wtleger80/RotatorFiles/UPDATED_Main_Drive_Gear.STL

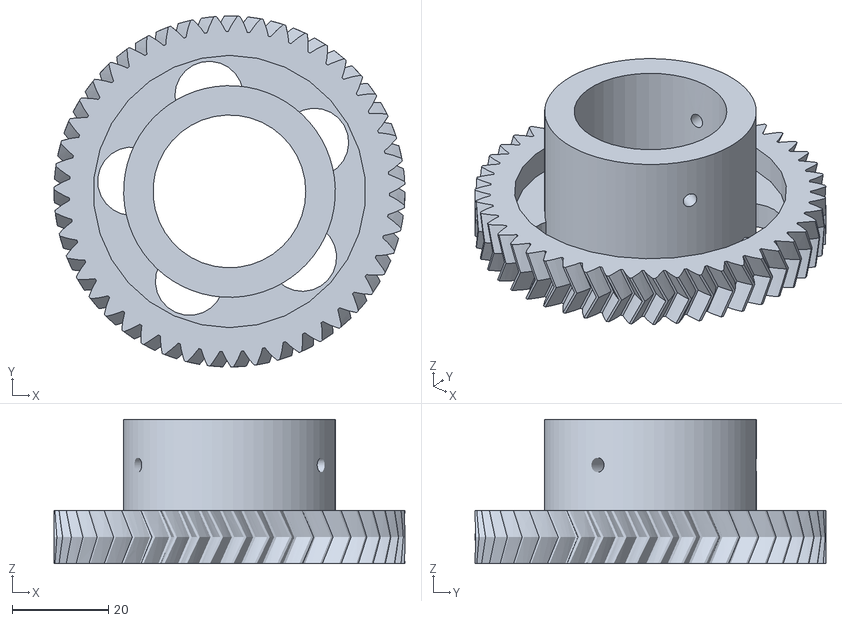
[picture p1: CAD file, 2022-07-05]
UPDATED_Main_Drive_Gear.STL
73.0 x 73.0 x 30.0
