wtleger80/RotatorFiles/Window_Blanking_Plate.stl

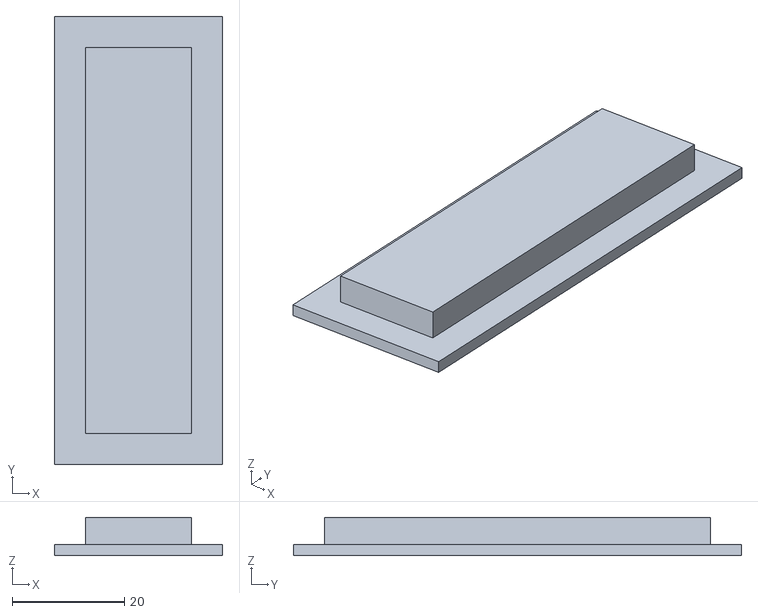
[picture p2: CAD file, 2022-07-05]
Window_Blanking_Plate.stl
30.0 x 80.0 x 6.85
