wtleger80/RotatorFiles/Pole_Mount_Clamp_Side.stl

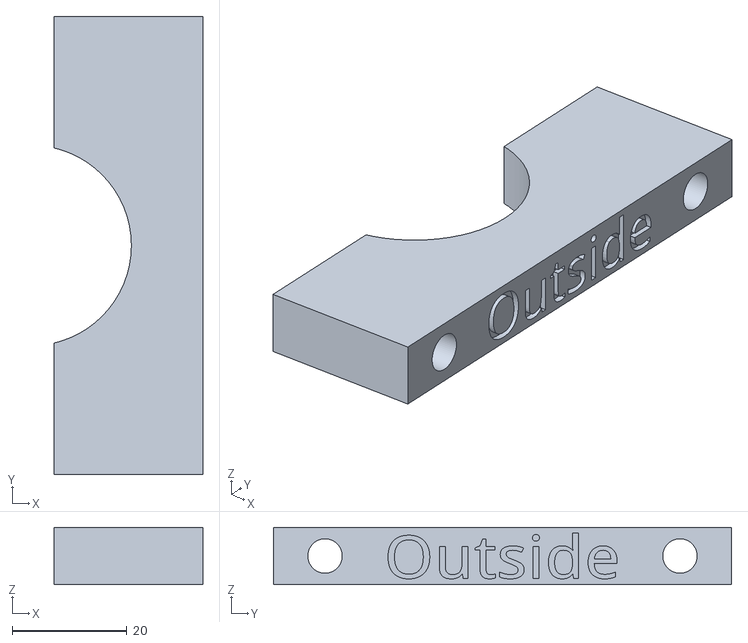
[picture p3: CAD file, 2022-07-05]
Pole_Mount_Clamp_Side.stl
26.0 x 80.0 x 10.0
