wtleger80/RotatorFiles/Pole_Mount_Case_Side.stl

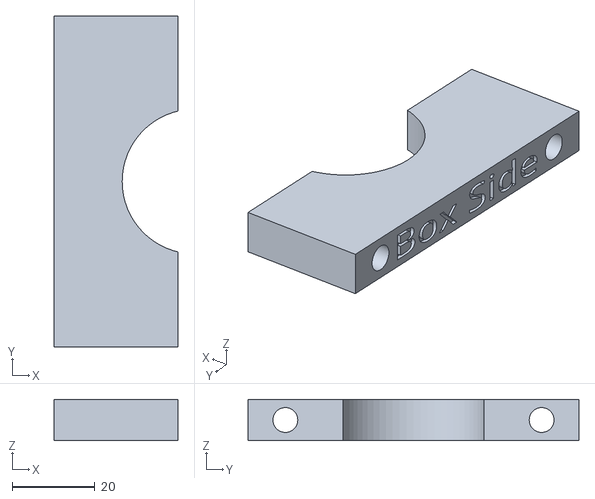
[picture p4: CAD file, 2022-07-05]
Pole_Mount_Case_Side.stl
30.0 x 80.0 x 10.0
