wtleger80/RotatorFiles/Case_Top.stl

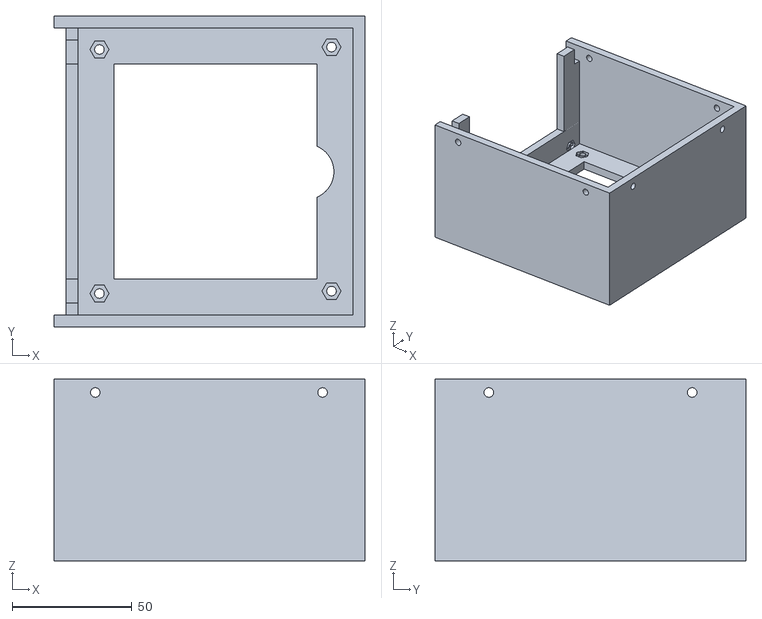
[picture p5: CAD file, 2022-07-05]
Case_Top.stl
130.0 x 130.0 x 76.0
