wtleger80/RotatorFiles/XT60_Bottom_Plate.stl

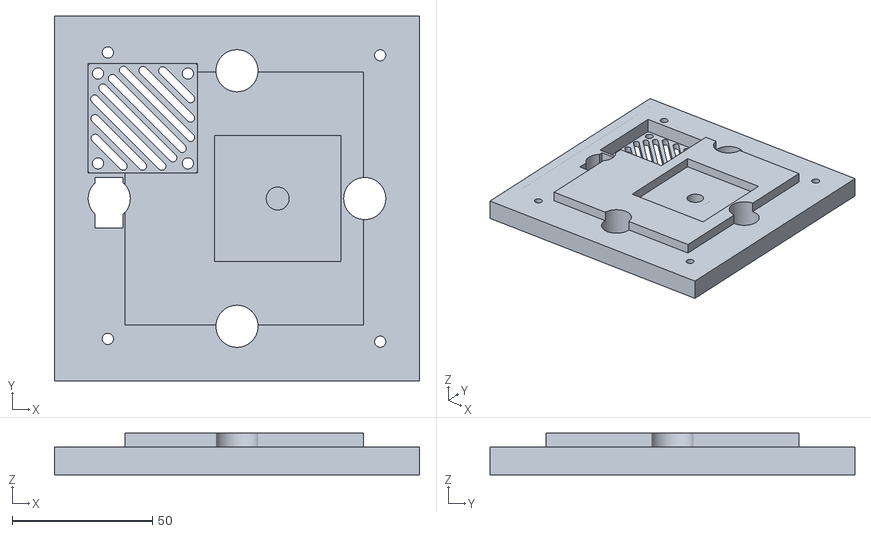
[picture p6: CAD file, 2022-07-05]
XT60_Bottom_Plate.stl
130.0 x 130.0 x 14.9
