wtleger80/RotatorFiles/UPDATED_Top_Bearing_Carrier.STL

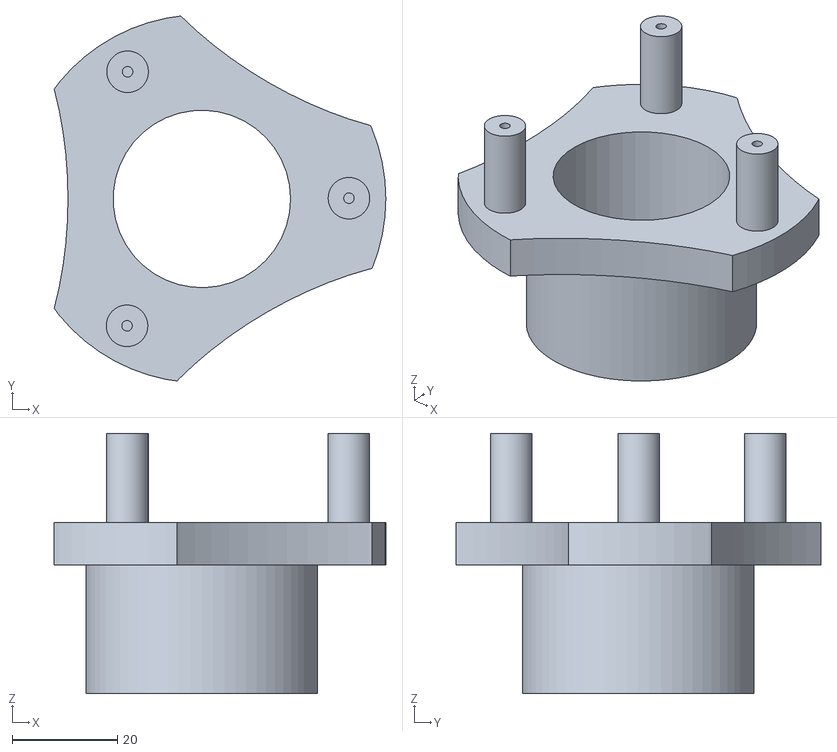
[picture p7: CAD file, 2022-07-05]
UPDATED_Top_Bearing_Carrier.STL
63.1 x 69.4 x 49.5
