wtleger80/RotatorFiles/Lower_Bearing_Holder.stl

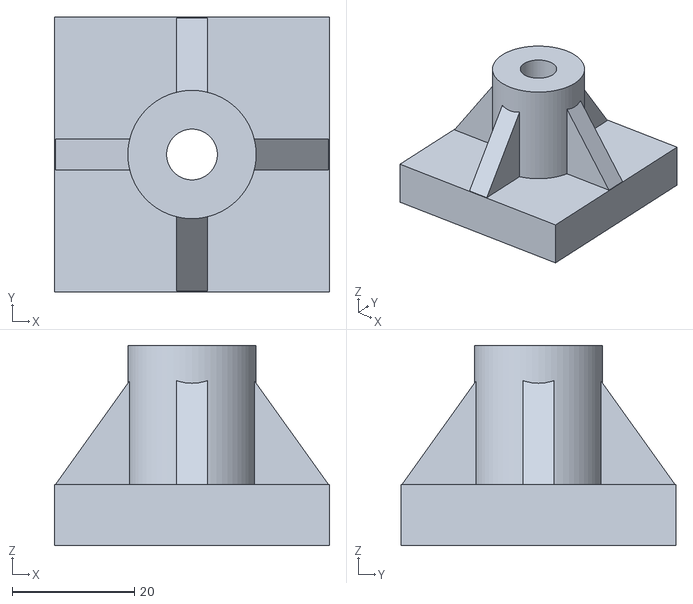
[picture p8: CAD file, 2022-07-05]
Lower_Bearing_Holder.stl
45.0 x 45.0 x 32.8
