wtleger80/RotatorFiles/UPDATED_TPU_Gasket.STL

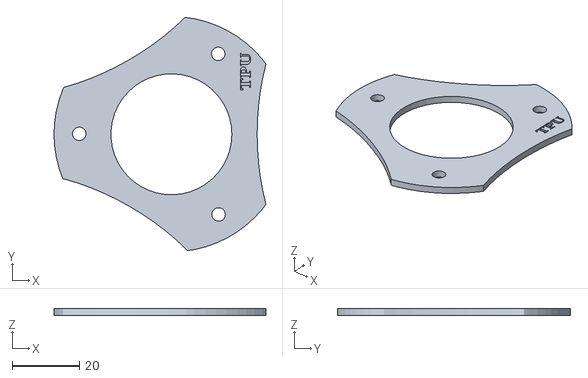
[picture p9: CAD file, 2022-07-05]
UPDATED_TPU_Gasket.STL
63.1 x 69.4 x 2.00
