wtleger80/RotatorFiles/Access_Cover_With_Window.stl

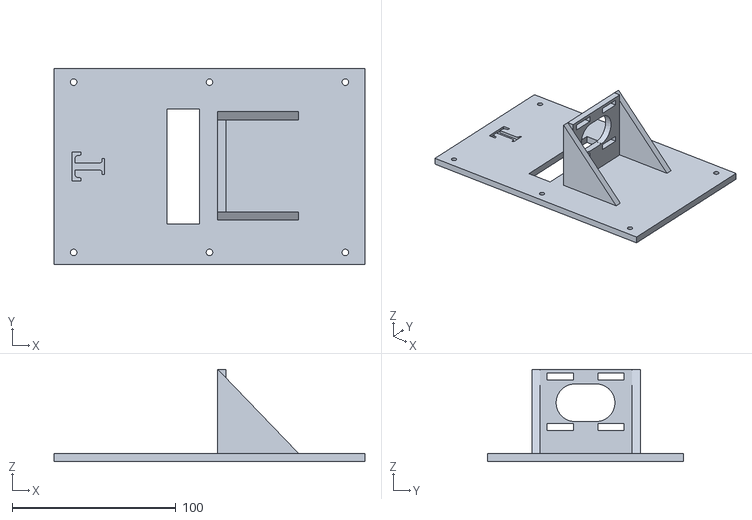
[picture p10: CAD file, 2022-07-05]
Access_Cover_With_Window.stl
190.0 x 120.0 x 56.5
