wtleger80/RotatorFiles/UPDATED_Waterproof_Top.STL

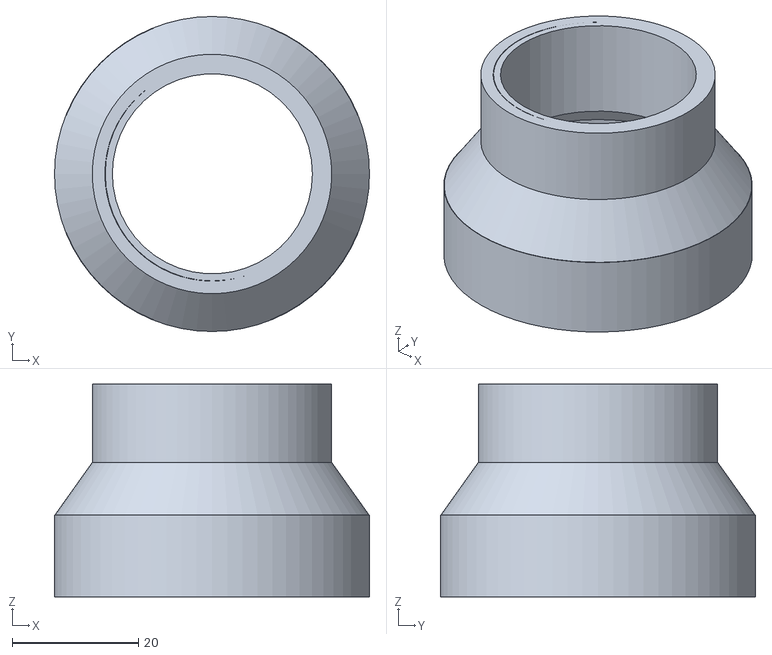
[picture p11: CAD file, 2022-07-05]
UPDATED_Waterproof_Top.STL
50.0 x 50.0 x 33.8
