wtleger80/RotatorFiles/UPDATED_Waterproof_Bottom.STL

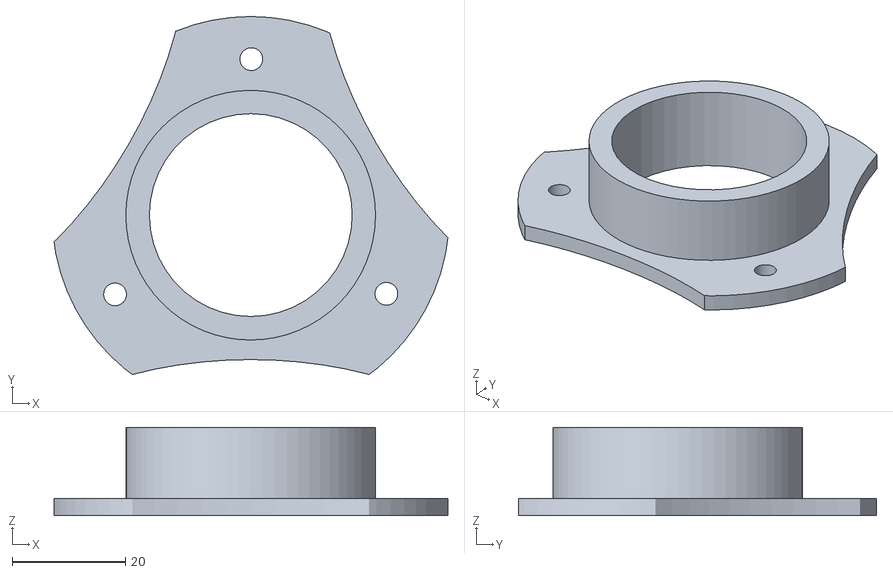
[picture p12: CAD file, 2022-07-05]
UPDATED_Waterproof_Bottom.STL
69.4 x 63.1 x 15.5
