wtleger80/RotatorFiles/UPDATED_Bottom_Tube_Mount.STL

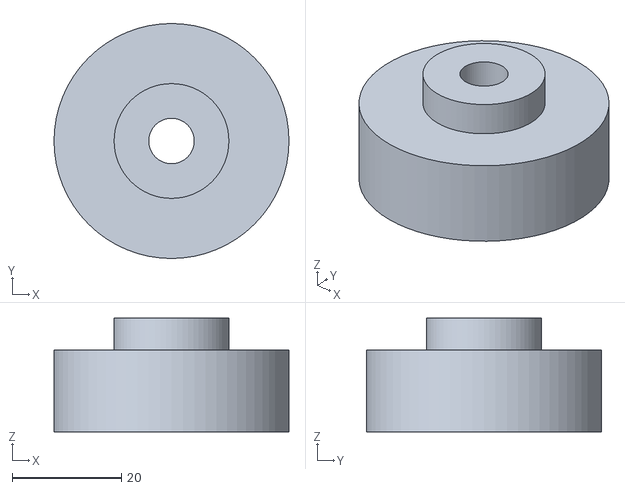
[picture p13: CAD file, 2022-07-05]
UPDATED_Bottom_Tube_Mount.STL
43.0 x 43.0 x 20.8
