wtleger80/RotatorFiles/Drive_Gear.stl

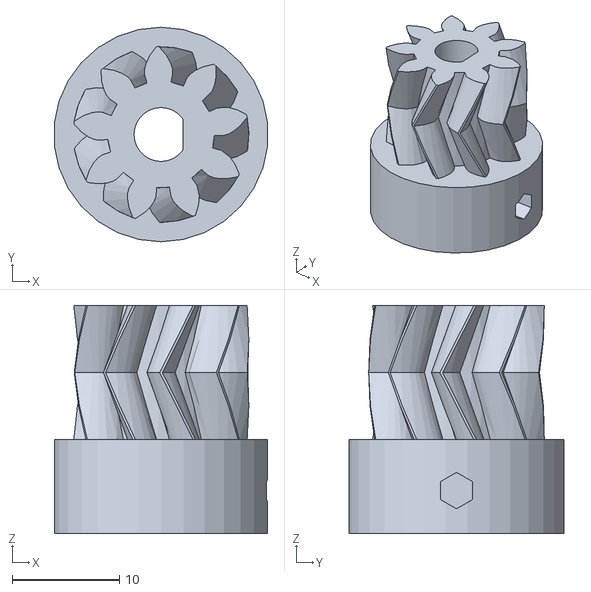
[picture p14: CAD file, 2022-07-05]
Drive_Gear.stl
19.9 x 20.0 x 21.2
