wtleger80/RotatorFiles/Case_Bottom.stl

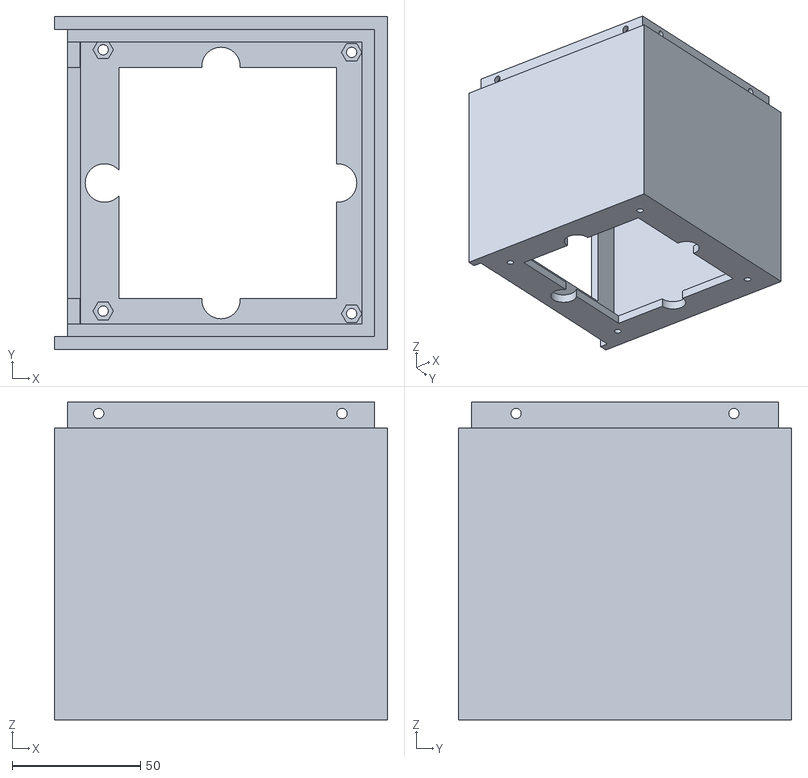
[picture p15: CAD file, 2022-07-05]
Case_Bottom.stl
130.0 x 130.0 x 124.0
