wtleger80/RotatorFiles/Access_Cover_With_Window_and_Optical_Endstop_Carrier.stl

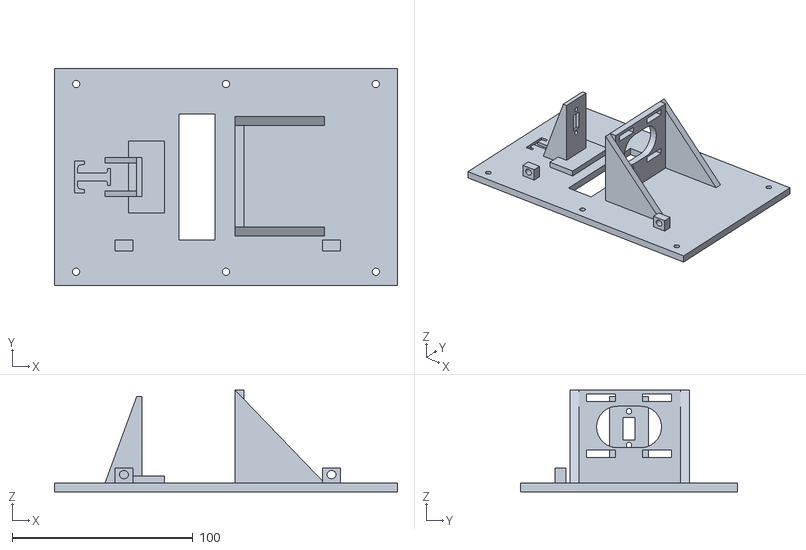
[picture p16: CAD file, 2022-07-05]
Access_Cover_With_Window_and_Optical_Endstop_Carrier.stl
190.0 x 120.0 x 56.5
