wtleger80/RotatorFiles/Optical_Endstop_Holder.stl

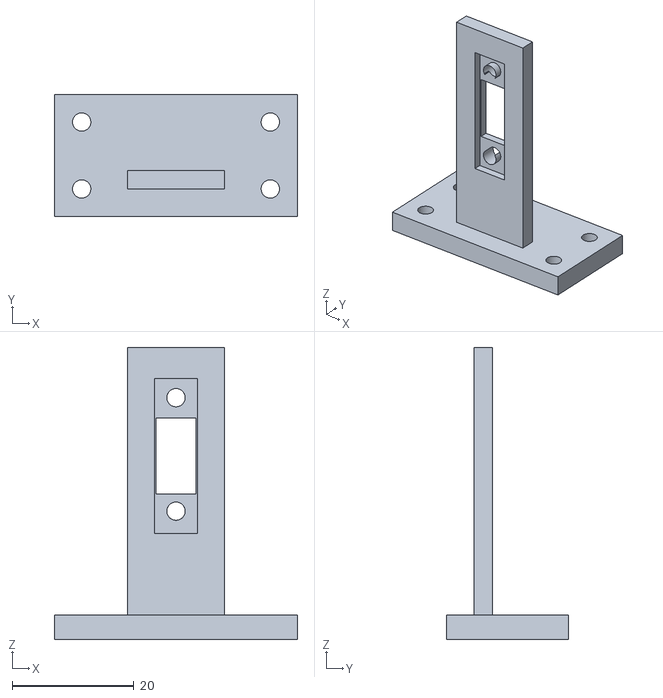
[picture p17: CAD file, 2022-07-05]
Optical_Endstop_Holder.stl
40.0 x 20.0 x 48.0
