wtleger80/RotatorFiles/UPDATED_Optical_EndStop_Interrupter.STL

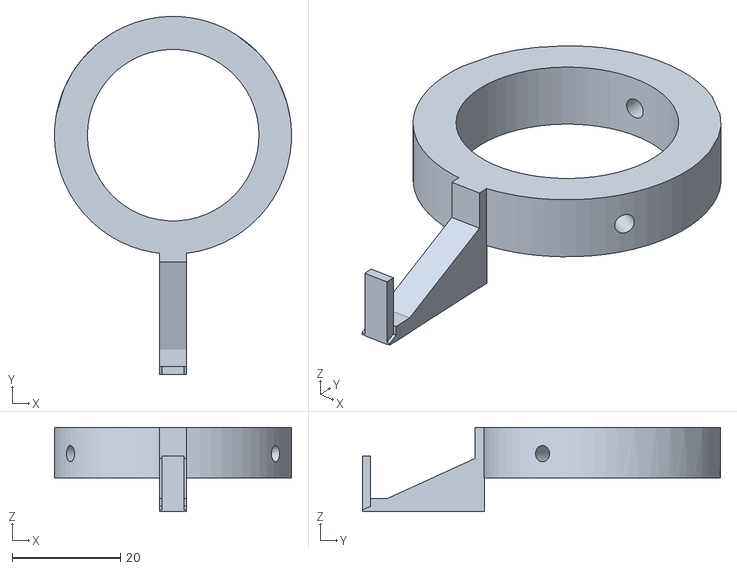
[picture p18: CAD file, 2022-07-05]
UPDATED_Optical_EndStop_Interrupter.STL
43.9 x 66.3 x 15.6
