wtleger80/RotatorFiles/UPDATED_Top_Plate.STL

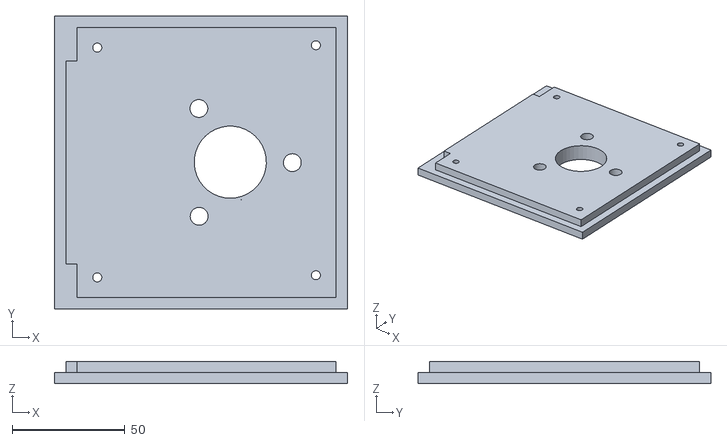
[picture p19: CAD file, 2022-07-05]
UPDATED_Top_Plate.STL
130.0 x 130.0 x 9.90
