wtleger80/RotatorFiles/ERC Version 4/PDF/eng_Instructions ERC RS232.pdf

ERC RS232 V4.0 | Instructions

### ___________________________________________________________________________

© Ing.-Büro E. Alba de Schmidt | Page 1 of 14 | web : www.schmidt-alba.de
Kreuzangerstr. 58 | 20210314 | email : erc@schmidt-alba.de
86399 Untermeitingen
This document is for the user only. Any publishing (printed or in electronic form) is not allowed.

Instructions

Congratulations on purchasing your EASY-ROTOR-CONTROL (ERC). This document will guide you through the needed steps for assembly, configuration and installation of the ERC. You will obtain the best result by following these instructions step by step.

Table of contents

### ___________________________________________________________________________

© Ing.-Büro E. Alba de Schmidt | Page 2 of 14 | web : www.schmidt-alba.de

## Safety-Instructions

- Don’t continue using the product if it is damaged.
- Keep electronic assemblies and components away from children.

### - Products that carry electric voltages must be handled in accordance with

instructions and regulations to avoid damage to equipment and personnel.

### - If the product must be repaired, use only original replacement parts. Using different parts may cause equipment damage and personal injury. Repairs should

be accomplished by a qualified individual.

### - Before applying main voltage the product must be securely build into a housing to

provide protection against accidental contact.
- The installation should be performed by a qualified individual.

### - Cables that carry dangerous voltages (e.g. main voltage) must be installed according to the valid instructions and regulations. The needed safety distances

must be maintained.
- Connection cables have to be chosen according to the needed diameter.
- Before working on the product all supply voltages must be disconnected.
- The product is designed to work in clean and dry areas inside buildings.
- Protect the product from humidity, water and heat.
- Don’t use the product in areas where explosive gas, vapour or dust may occur.

### - Don’t let the product fall or apply mechanical stress as the product may be

damaged.

### ___________________________________________________________________________

© Ing.-Büro E. Alba de Schmidt | Page 3 of 14 | web : www.schmidt-alba.de

## 1. Bill of Material (BOM)

The Bom is in the order how you should use the parts.
ERC RS232 V4.0 Bill Of Material
QTY | Type | Value | Pitch | Reference | Comments
RS232-Cable
1 | Cabel with Phonejack | 3.5mm Stereo 1.25m | for RS232 Adapter
1 | DSUB-Connector | 9 pol. Female | for RS232 Adapter
1 | DSUB-Case | for 9 pol. | for RS232 Adapter
PCB Assembly
1 | PCB ERC | 2-layer 80x61mm V4.0
2 | Capacitor ceramic | 22p 16V 5% | 2.5 | C1,C2
1 | Crystal | 9.8304 MHz HC49U | | Q1
1 | IC-Socket | 28 pol. DIL28 | | IC1* | for IC1
2 | IC-Socket | 16 pol. DIL16 | | IC2*,IC3* | for IC2,IC3
1 | Phone-Jack | 3.5mm Stereo | | X1 | RS232
8 | Capacitor ceramic | 100n 50V 20% | 2.5 | C3-C10
7 | Capacitor Tantal | 1u 35V 20% | 2.5 | C11-C17
1 | Mini-Fuse | 1.0A | 5 | F1
1 | Voltage-Regulator | 78L05 TO92 | | IC4
1 | Pinheader | 1x2 pol. | 2.5 | JP1
3 | Resistor | 20K 5% | 2.5 | R1-R3
1 | Resistor | 39K 5% | 2.5 | R4
1 | Resistor | 220K 5% | 2.5 | R5
1 | Diode | 1N4004 | 2.5 | D1 | alt.: 1N4005-4007
2 | Coil | 10u 10% SMCC | 2.5 | L1,L2
1 | Diode | P6KE33CA | 3.81 | D2
2 | Terminal-block | 2 pol. 5mm | 5 | X3,X4
4 | Terminal-block | 3 pol. 5mm | 5 | X5-X8
1 | DC-Jack | 2.1/5.5mm | | J1 | DC
1 | Capacitor Al | 100u 16V 20% | 2.5 | C18
3 | Relais | RT424012 | | K1-K3 | alt.: F1CL012R
Mechanical Assembly and ICs on socket
1 | IC | MAX232CPE | DIL16 | IC3 | with socket
1 | IC | ULN2003AN | DIL16 | IC2 | with socket
1 | IC | MEGA328P-20PU | DIL28 | IC1 | with socket
1 | DC-Connector | 2.1/5.5/14mm | | | for DC
1 | Jumper | 2 pol. | 2.5 | JP1* | on JP1 / Reset
4 | Distance-Bolt | M3x8x6mm
8 | Spring-Wascher | 3.2mm
4 | Nuts | M3
4 | Screw | M3x6mm
2 | Mounting Angle | 11x10x7mm
1 | Cable | blue 1m 0.75sqmm | | | for installation
1 | Cable | black 1m 0.75sqmm | | | for installation
3 | Cable-Ties | 150mm | | | for installation

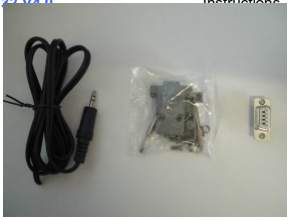
[picture p43: figure]
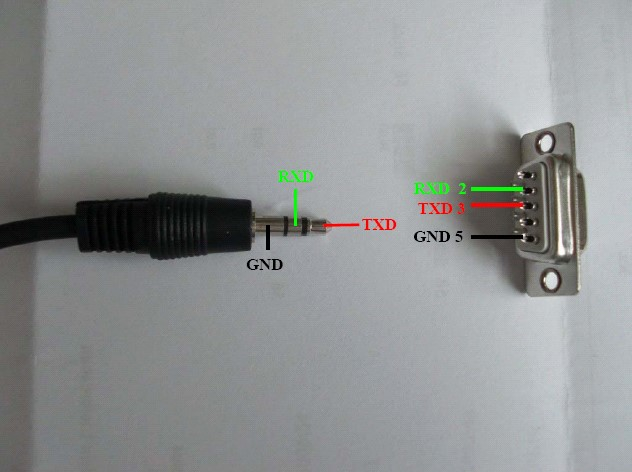
[picture p44: figure]

### ___________________________________________________________________________

© Ing.-Büro E. Alba de Schmidt | Page 4 of 14 | web : www.schmidt-alba.de

## 2. Assembly of RS232 cable

Materials needed:

- Cable with 3.5mm Stereo phone jack
- DSUB-connector 9 pole female
- DSUB-case for 9 pole

Pinning of DSUB seen from the connector-frontside

Cables shipped with the kit may differ in color. The kit builder needs to decide which of the inner cables is to be connected to what contact of the phone jack. Alternatively to the 3-wire cable a 2-wire cable with shielding may be included in the kit. For this kind of cable both shielding must be twisted together. The shielding is representing GND.

GND: inner contact (sleeve) of the phone-jack : to PIN 5 of the D-SUB
RXD: middle (ring) contact of the phone-jack : to PIN 2 of the DSUB
TXD: tip-contact of the phone-jack : to PIN 3 of the DSUB

### ___________________________________________________________________________

© Ing.-Büro E. Alba de Schmidt | Page 5 of 14 | web : www.schmidt-alba.de

## 3. Assembly of PCB

Assemble and solder the components according to the following drawings.

Please read the following instructions carefully before you start:

### 1. The vertical assembled Diodes should have a distance (1-2mm) away from the PCB while

soldering. Otherwise there is the risk of overheating these components while soldering.

### 2. Carefully observe polarization of the following components :

- Diode D1 (D2 is bidirectional, no polarization)
- Aluminum Capacitor C18
- Tantalum-Capacitors C11,C12,C13,C14,C15,C16,C17
- Voltage Regulator IC4
- IC-Sockets IC1*,IC2*,IC3*
- Connectors X3,X4,X5,X6,X7,X8 (cable entry toward the perimeter of the board)

These components are shaded in red in the following drawing.

Components :

Color code of Resistors:
20K 5% | red-black-orange-gold
alt.: 20K 1% | red-black-black-red- brown
39K 5% | orange-white-orange-gold
alt.: 39K 1% | orange-white-black-red-brown
220K 5% | red-red-yellow-gold
alt.: 220K 1% red-red-black-orange-brown

Color code of Coils:
10uH 10% brown-black-black-silver (they also resemble resistors)

Diodes :

| =

The following components are not assembled in the RS232-version: X2

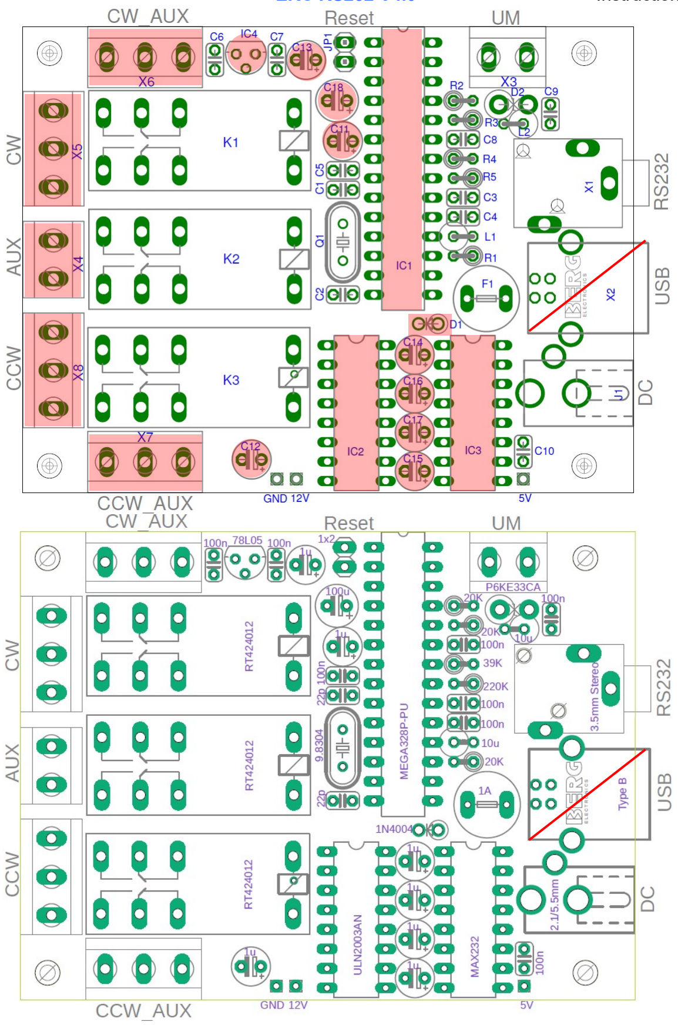
[picture p45: figure]

### ___________________________________________________________________________

© Ing.-Büro E. Alba de Schmidt | Page 6 of 14 | web : www.schmidt-alba.de


### ___________________________________________________________________________

© Ing.-Büro E. Alba de Schmidt | Page 7 of 14 | web : www.schmidt-alba.de

After assembly, attach the 4 bolts and the 2 mounting angles with nuts for mounting. Use spring-washers below the nuts.

Check the assembly carefully to insure it resembles this photo.

Do not place the ICs (MEGA328, MAX232 and ULN2003) into their sockets until the following testing is completed.

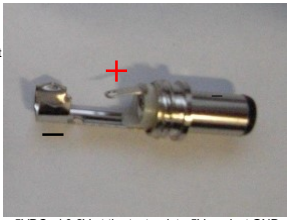
[picture p46: figure]
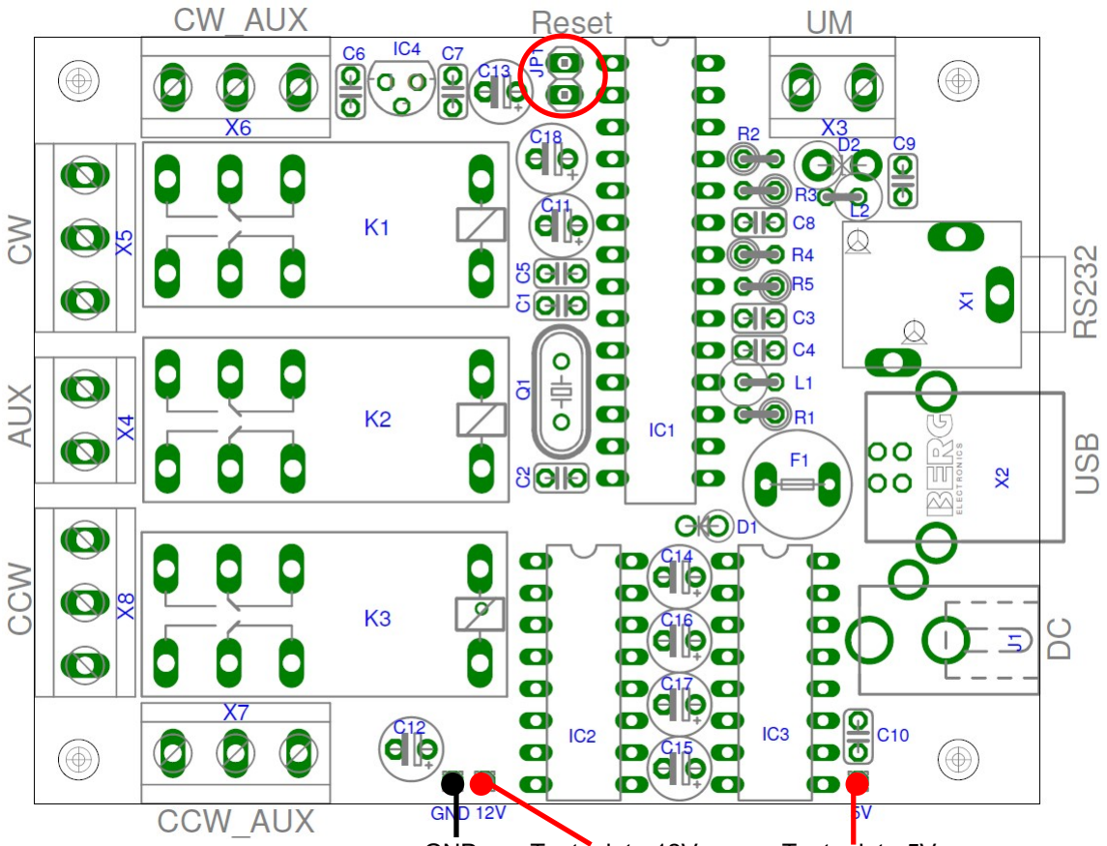
[picture p47: figure]

### ___________________________________________________________________________

© Ing.-Büro E. Alba de Schmidt | Page 8 of 14 | web : www.schmidt-alba.de

## 4. Connection of the DC-supply and check of the voltage-regulator

After checking all assembled components for identity, polarization and solder bridges, connect 11 to 15VDC to connector J1. This can be done by using the DC connector supplied with the kit or any other DC source with an appropriate DC connector of 2.1/5.5mm and Plus(+) on the centre-pin.

Connect the Plus(+)-pole to the centre contact
and the Minus(-)-pole to the outer contact.

If DC is reversed, nothing will happen as the circuit is protected from reverse polarization.

Now put the Jumper on connector JP1 (the Jumper must remain on JP1 for normal operation).

After connecting DC correctly, you should measure +5VDC +/-0.2V at the test-point +5V against GND.

GND | Testpoint +12V | Testpoint +5V

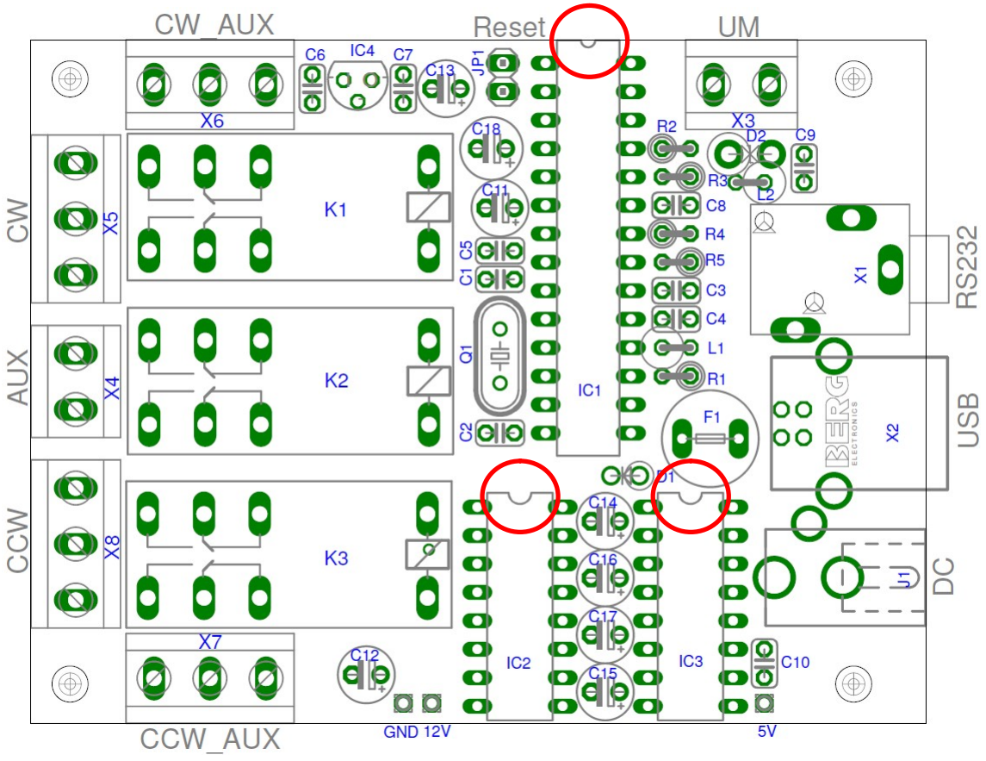
[picture p48: figure]

### ___________________________________________________________________________

© Ing.-Büro E. Alba de Schmidt | Page 9 of 14 | web : www.schmidt-alba.de

## 5. Insert ICs

Remove DC from the ERC before inserting the ICs.
The pins of the ICs have to bend before you can put them into their sockets. Use a hard base (e.g. your working desk) and
bend the row of pins slightly, that they get an angle of 90°.
Now insert the ICs and take care about direction of the components and not to bend any pins while inserting the components into the sockets.

## 6. The Service-Tool

The Service Tool is on the CD supplied with the kit.

Start the Setup-File SETUP ERC-M_Vnn.EXE (nn=version) directly on the CD and follow the instructions.

The installation wizard will automatically install the Service Tool in the program directory (or any other if you choose a different one) and put an icon on your desktop.

Connect the ERC to DC and to the PC with the RS232-cable.

Start the Service Tool by double-clicking the Icon on the desktop.

### ___________________________________________________________________________

© Ing.-Büro E. Alba de Schmidt | Page 10 of 14 | web : www.schmidt-alba.de

### 6.1 Configuration of the COM-Port

On shipment, the Service Tool is configured to COM1, which is most properly not the com-port, where you connected the ERC, hence after Start-Up the program may bring up an error-message because of the wrong COM-Port.

Choose the right COM-Port.

The Service Tool will check the availability of the ERC at the chosen COM-Port. If successful, the Service Tool will read the configuration-parameters of the ERC and populates the configuration- and the calibration-windows.

You can now perform a little hardware-test before the installation. Click the | -button and all
relays will be switched on sequentially.

### 6.2 Read the ERC-configuration-parameters

The parameters of the ERC can be read by clicking the | button.

### 6.3 Language

The Service-Tool and the help-files are available in different languages. Choose the language with the -box.

### 6.4 Configuration of the AUX-relay

Depending on the rotator used, you need to configure the function of the 3rd relay. Otherwise the rotator may not move.
Please check in the installation-guide which setting is needed for your type of rotator.
Choose the desired function in | .

### 6.5 Other functions of the Service Tool

The other functions of the Service Tool are well described in the help-function of the Service Tool.

Click the | button.

## 7. Installation of the ERC

Easy-Rotor-Control can either be installed in the rotor-controllers housing or in certain cases it can be installed on the outside of the housing. The installation is unique to every type of rotor/controller. Therefore the installation-guide on the CD, shipped with your ERC, provides instructions for each type of rotator control..

## 8. Theory of operation

A Microcontroller receives commands via the RS232-interface in the Yaesu GS-232B (or GS-232A) or Hygain DCU-1 protocol from the programs that support controlling rotators.

### ___________________________________________________________________________

© Ing.-Büro E. Alba de Schmidt | Page 11 of 14 | web : www.schmidt-alba.de

The ERC takes the task to move the rotator to the desired position or to stop the rotator while it is moving. Also changes of the direction are possible while the rotator is moving. The current position of the rotators is calculated from the measured rotor-feedback-voltage. To achieve accurate function, the ERC has to be calibrated to the specific value of the rotor-feedback-voltages (ref. to the next chapter).

Depending on the direction to move, the CW- and CCW-relays are activated. With a programmable delay the AUX-relay will be activated to control the speed or the brake of the rotator.

The ERC is powered by external 11..15VDC. Wherever there is a suitable DC-supply available on the rotor-controllers remote-jack, it is taken from there to supply the ERC..

## 9. Calibration

After the ERC is connected to the rotor-controller, it has to be calibrated. This calibration is needed, because different kinds of rotators deliver different kinds of feedback-voltages. Also variations
between rotators of the same model would lead to inaccuracy. To calibrate the ERC, it has to measure the rotor-feedback-voltages at both ends including overlaps (turning radius > 360°). The calibration is
a software-guided procedure, which will be started by pressing the | button of the service
tool. Just follow the instructions given by the calibration assistant.

After pressing the calibrate-button, the calibration is always done in 3 steps:
1. Decide if you want to calibrate an elevation- or an azimuth-rotator and confirm with the OK-button.
2. Move the rotator to the most clockwise (right) position (to the most upwards position if it is an elevation-rotator), fill in the value, that the dial of your rotator shows and confirm with the OK-button.
3. Move the rotator to the most counter-clockwise (left) position (to the most downwards position, if it is an elevation-rotator), fill in the value, that the dial of your rotator shows and confirm with the OK-button

Please note, that the value to be filled in during the calibration-steps 2 and 3 is always the true value that the dial of your rotator shows. Don’t put values like 450 (if you have a rotator with overhead) or -180° (if your rotator has the stop in south) or anything else that is not shown on the dial of your rotator.

Here are some examples:
- Azimuth-rotator with 360° turning-range and start at 0°: Step 1 = 360, Step 2 = 0
- Azimuth rotator with 360° turning-range and start at 180°: Step 1 = 180, Step 2 = 180
- Azimuth-rotator with 450° turning-range and start at 0°: Step 1 = 90, Step 2 = 0
- Azimuth rotator with 450° turning-range and start at 180°: Step 1 = 270, Step 2 = 180
- Elevation-rotator with 90° turning-range: Step 1 = 90, Step 2 = 0
Don’t worry, the ERC will understand and make a correct calibration out of this.

EVERY position for the calibration of an azimuth-rotator is possible, if it is calibrated within a range of > 180° and < 540°.

After calibration, the Service-Tool will show the results of the calibration in the Calibration-data panel:
- Antenna-type
o 0 AZ if you have calibrated an azimuth-rotator
o 1 EL if you have calibrated an elevation-rotator
- ADC-data
o First value is the range of voltage that has been chosen by the ERC in order to optimize the resolution (auto-range measurement).
- 0/1/2 for axis 1 = range 16V/8V/4V
- 3/4/5 for axis 2 = range 16V/8V/4V
o Second value is the ADC-value of the feedback-voltage measured at the most counter-clockwise (most downward) position.

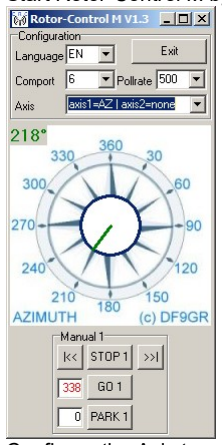
[picture p49: figure]

### ___________________________________________________________________________

© Ing.-Büro E. Alba de Schmidt | Page 12 of 14 | web : www.schmidt-alba.de

o Third value is the ADC-value of the feedback-voltage measured at the most clockwise (most upwards) position.
o The third value must always be greater than the second value as the feedback-voltage must increase while the rotator is moving clockwise or upwards.

If the feedback-voltage of the rotator has unlinearities, an extended calibration can be performed every

30° by pressing the | button. The installation-guide will tell you, if your specific rotator
needs an extended calibration.

## 10. First check of calibration with Rotor-Control M

The rotor-control-program Rotor-Control M is on the CD supplied with the kit.

Start the Setup-File SETUP RC-M_Vnn.EXE directly on the CD and follow the instructions.
The installation wizard will automatically install the Service Tool in the program directory (or any other if you choose a different one) and puts an icon on your desktop.

Set the ERC with the Service-Tool to Baudrate 9600 and Protocol GS232B and close the Service-Tool.

It is important to close the Service-Tool before you start the Rotor Control M because Windows does not allow that more than 1 application is accessing a comport at the same time.

Start Rotor-Control M by double-clicking the Icon on the desktop.

Configure the Axis to <axis1=AZ | axis2=none>.

The green pointer and number show the current position of the rotator.
Targets can be put at the red numbers and the rotator moves after pressing the GO-button. The STOP-button will terminate rotation.

You can also move the rotator to a target-position by clicking on any point of the graphics. By clicking the button PARK, the rotator move to the configured parking position.

### ___________________________________________________________________________

© Ing.-Büro E. Alba de Schmidt | Page 13 of 14 | web : www.schmidt-alba.de

## 11. Connect the ERC to other programs

Please take care about the following issues, if you want to control your ERC with other programs:

- Choose the right COM-port
- COM-port-speed in the program must be same as in ERC
- Adjust the comport in the program to : N-8-1 (No Parity, 8 databits,1 stopbit)
- Use the same protocol in program and ERC (Yaesu GS232B, GS232A or Hygain DCU-1)

More detailed information about specific program-setups can be found on our web-page in the Software-Guide.


### ___________________________________________________________________________

© Ing.-Büro E. Alba de Schmidt | Page 14 of 14 | web : www.schmidt-alba.de

## Appendix A: Schematics
